OhmDazzle/YLD_Cup/Core/logic-framework.png

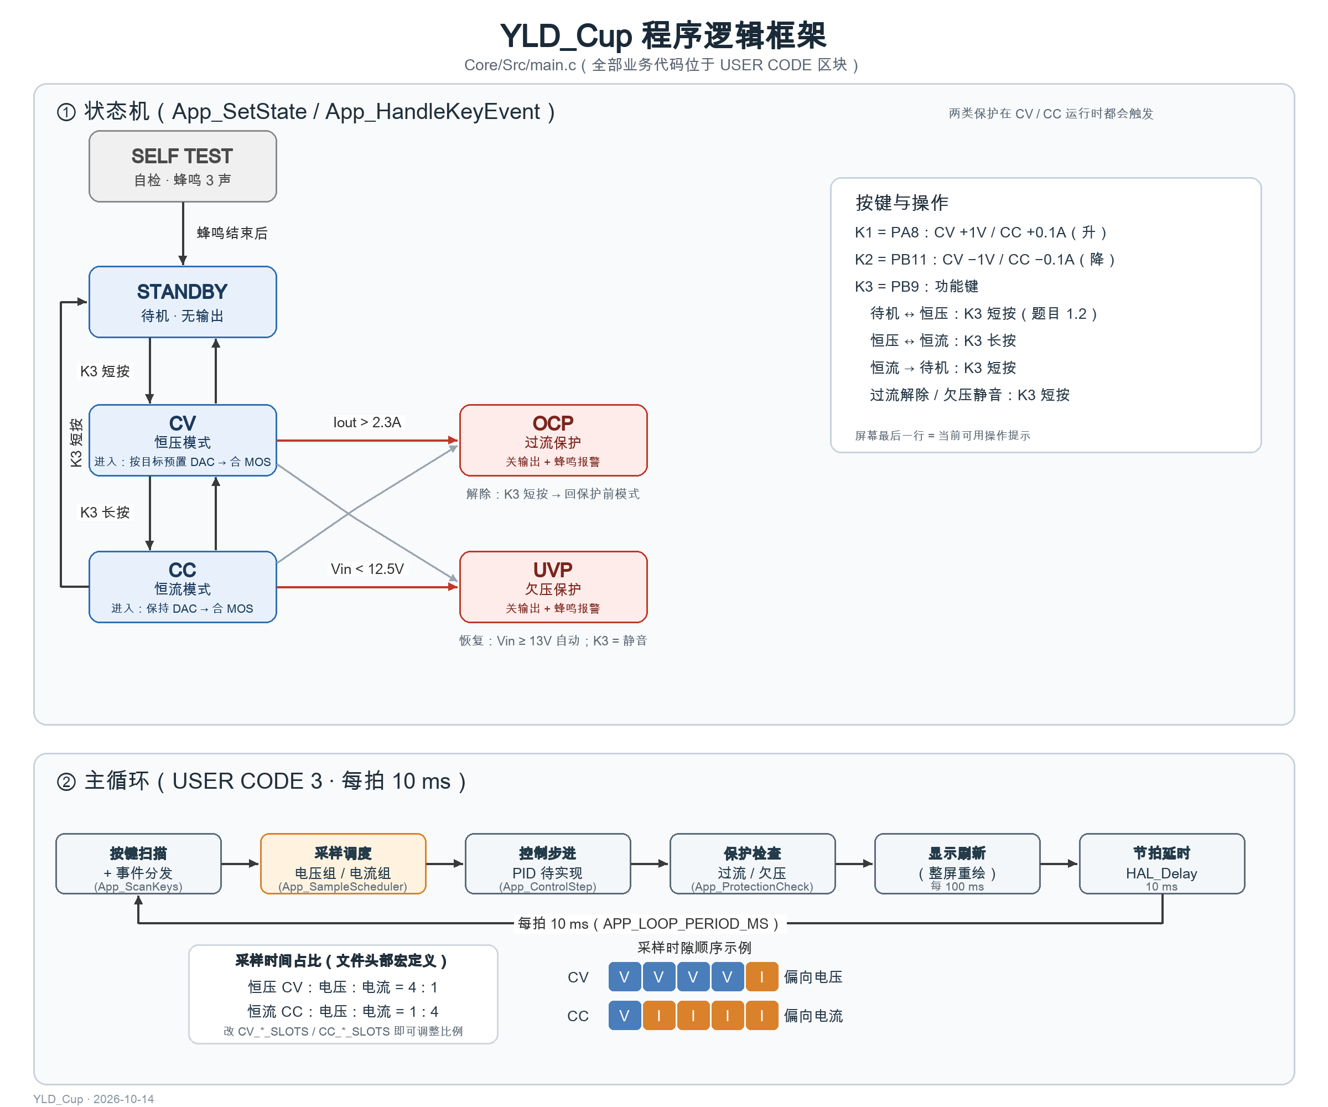
Core/logic-framework.png
