OhmDazzle/YLD_Cup/calibration/voltage_v2_2026-10-27.md

# V2.08 电压输出与采样校准

依据用户提供的《实验数据V2.pdf》，先用第二页校准 DAC 控制的端子输出，再用第一页校准 ADC 电压读数。用户确认采集固件为 V2.06/V2.07，并确认第一页第 20 组“测得输出电压”应为 **7.51V**。原始 `0.751` 保存在 `measurements_2026-10-27.json`，修订单独记录，计算时应用。两路电流、Vin 及保护阈值沿用原参数。

## 第二页：两步拟合 DAC 输出控制

第二页共 20 组，输入 16V，原设定电压 5、6、7、8、9V，负载电流 0.5、1、1.5、2A。表中没有 PA4 引脚的仪表读数，因此这是“DAC 命令到实际输出端子电压”的校准，不能据此声称独立校准了 PA4 的物理电压。

第一步：各电流组分别拟合 `V实际 = K × S + B`，其中 `S` 为原固件的设定电压。

| 电流 I / A | K | B / V |
| --- | --- | --- |
| 0.5 | 1.009 | -0.354 |
| 1.0 | 1.010 | -0.430 |
| 1.5 | 1.007 | -0.474 |
| 2.0 | 1.005 | -0.513 |

第二步：分别对 K、B 与电流 I 作线性最小二乘拟合：

```text
K(I) = 1.0115 - 0.003 × I
B(I) = -0.3125 - 0.1042 × I
V实际 = K(I) × S + B(I)
```

对于目标端子电压 `V目标`，反解原设定量，再沿用采集时的 DAC 基础映射：

```text
S补偿 = (V目标 + 0.3125 + 0.1042 × I) / (1.0115 - 0.003 × I)
Vdac = (17.07091 - S补偿) / 4.545455
DAC码 = round(Vdac × 4095 / 3.3)
```

例如目标 8V、负载 2A，`S补偿 ≈ 8.47429V`，`Vdac ≈ 1.89126V`，12 位 DAC 码约 **2347**。DAC 电压降低会提高电源输出，补偿方向与本板负增益通路一致。

主程序 `App_TargetToDac()`、开机预置、进入 CV、按键调压统一使用该反解。`App_ControlStep()` 在 CV 下每拍用最新校正电流更新静态前馈；CV 默认每五拍更新一次电流，屏幕平均不参与补偿。保护检查先于前馈执行；待机、保护、主程序 CC 不执行 CV 前馈。主程序的电压 PID 和恒流 PID 仍未实现。

范围处理：目标在 5-9V 时使用上述反解；高于 9V 或低于 5V 时保留边界处的校准增量，再加回目标电压，避免继续外推电压增益。电流用于 DAC 补偿时限制在 0-2A，0-0.5A 是向零电流的外推；大于 2A 时保持 2A 的补偿。**测量电流本身没有限到 2A**，过流判断仍使用真实换算值。最终 PA4 命令仍限在 0.2-3.1V，非有限值取 3.1V。

第二页仅在 16V 输入下采集，9V 目标反解的原设定量也会略高于原扫描上限；新电压、负载和温度条件均需复测。补偿不会提高降压芯片本身的带载能力。

## 第一页：ADC 输出电压校准

第一页共 20 组，均为 8V 设定的负载扫描，外表端子电压范围为 7.521-7.810V。其“测得输出电压”和“测得输出电流”已经使用 V2.06/V2.07 校准，不能再当成未经校准的 ADC 名义值。

这些电压和电流随负载一起变化，不能从这段窄扫描稳定分离出新的全量程电压增益与电流压降。保留原电压增益，对“外表读数减旧 OLED 电压”的残差按旧 OLED 已校正电流拟合：

```text
V新 = V旧 + 0.021567519 - 0.003348423 × Iout
```

其中 `Iout` 单位为 A。结合原有换算，固件的等价式为：

```text
Vnominal = PA6 引脚电压 × 7
V新 = 1.015199746 × Vnominal - 0.058501414 × Iout + 0.005166809
```

真实 0V 仍返回 0；负数钳为 0。电压组和电流组更新时，均从缓存的 `measVoutNominal` 重算，不会反复叠加校准。主程序和独立恒流调参固件共用新的 `Cal_Vout()`；独立调参程序继续直接控制 DAC，不叠加主程序的 CV 前馈。原始 ADC/DAC 模块测试与 `TEST/` 采集工具继续提供原始命令、原始读数。

## 回代结果与边界

| 项目 | 样本数 | 校准前平均绝对偏差 | 校准后平均绝对残差 | 校准后最大绝对残差 |
| --- | --- | --- | --- | --- |
| 第二页输出模型 | 20 | 388.50mV | 4.06mV | 7.90mV |
| 第二页模型反解并考虑 DAC 量化 | 20 | 388.50mV | 4.39mV | 7.50mV |
| 第一页 ADC 读数 | 20 | 18.05mV | 1.97mV | 5.88mV |

第一行是原设定量到原实测输出的模型回代。第二行保留每个原实测锚点的残差，按该电流的拟合斜率估计补偿后的变化，再计入 12 位 DAC 量化；属于模型估计，没有将正反函数相消得到的零误差当作验证。以上均为同批样本上的数值结果，OLED 数据仅显示到 0.01V，不能将这些残差宣称为烧录后毫伏级精度。

第一页未在第二页 DAC 新补偿启用后重新采集；ADC trim 仍可作用于同一测量链路，但新输出点，尤其 9-15V、0-0.5A 和负载瞬态，需独立台架复测。第一页与第二页相近条件下也有数十毫伏差异，说明重复条件及温度等会影响实际结果。

## 重现与验证

```sh
python3 calibration/fit_voltage_v2.py
python3 calibration/fit_measurements.py
python3 tests/run_voltage_calibration.py
python3 tests/run_measurement_calibration.py
python3 tests/run_main_logic.py
python3 tests/run_module_logic.py
python3 tests/run_cc_pid.py
python3 tests/run_buzzer_logic.py
cmake --preset Release
cmake --build --preset Release
```

`fit_voltage_v2.py` 先处理第二页，再处理第一页，生成 `Core/Inc/voltage_calibration.h` 与 `voltage_fit_results_2026-10-27.json`。`fit_measurements.py` 重现 V2.06 的基础系数，生成的共享测量头文件引用新电压头文件并应用一次 ADC 残差修正。两脚本无第三方依赖；原 2026-10-25 数据及审计保留为历史依据。

验证将 20 组 ADC 数据与 20 组 DAC 实测锚点送入实际 C 函数，覆盖量化、全 ADC 量程单调性、目标单调性与边界连续性。另回归原 35 组电流、主程序状态/保护、模块测试、蜂鸣器和独立恒流算法。软件验证通过不能替代上板复测；本次未烧录设备。
