OhmDazzle/YLD_Cup/TEST/logic-framework.png

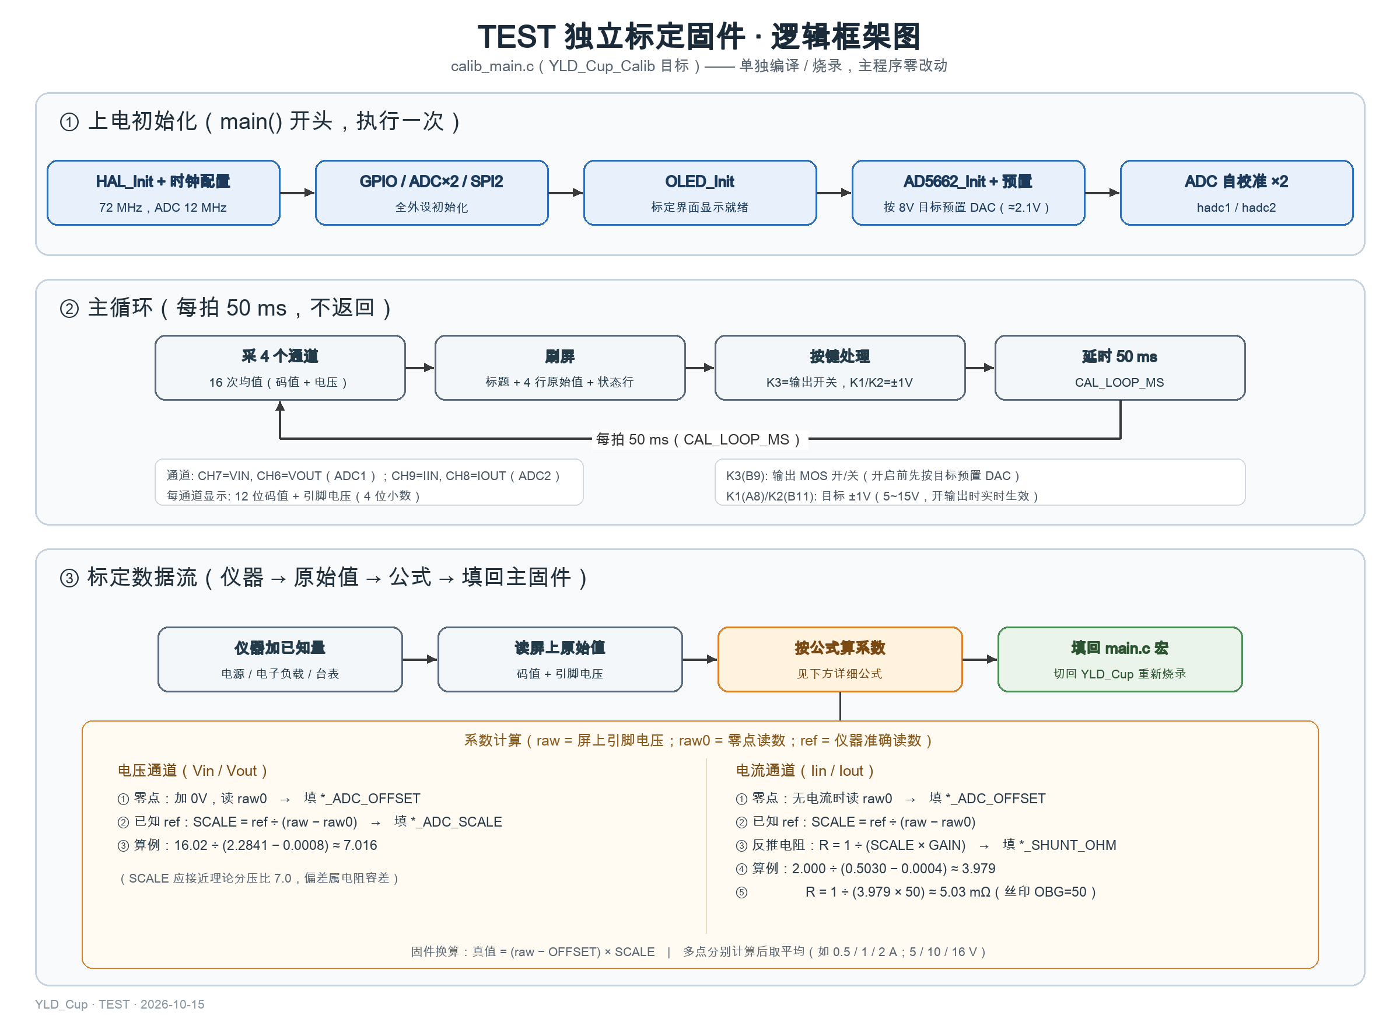
TEST/logic-framework.png
