OhmDazzle/YLD_Cup/YLD_CUP.ioc

Mcu.UserName=STM32G431CBTx
PA1.Signal=GPIO_Output
PA13.Signal=SYS_JTMS-SWDIO
PA14.Signal=SYS_JTCK-SWCLK
PA2.Signal=GPIO_Output
PA4.Signal=COMP_DAC11_group
PA6.Signal=ADC2_IN3
PA7.Signal=ADC2_IN4
PB0.Signal=ADC1_IN15
PB1.Signal=ADC1_IN12
PB13.Signal=GPIO_Input
PB14.Signal=GPIO_Input
PB15.Signal=GPIO_Input
PB3.Signal=GPIO_Output
PB4.Signal=GPIO_Output
PF0-OSC_IN.Signal=RCC_OSC_IN
PF1-OSC_OUT.Signal=RCC_OSC_OUT
