OhmDazzle/YLD_Cup/(commit log)

2026-09-24 V0.1 创建了一个文件夹
2026-09-24 V0.2 加入OLED模块 将江协科技OLED驱动加入代码库 SCL接PB8，SDA接PB9的测试未更改
2026-09-24 V0.3 借助cubemx打开端口复用功能
2026-09-24 V0.4 借助cubemx初始化四个ADC口
2026-09-24 V0.5 ADC端口读取电压，赋值给INA_*
2026-09-30 V0.6 修改时钟源为外部晶振
2026-09-30 V0.7 利用CubeMX初始化按键输入口，初始化三极管控制电路
2026-09-30 V0.7 利用CubeMX初始化DAC外设三个口
2026-09-30 V0.8 利用吃白饭的鲸鱼写了DAC外设的驱动，使用方式写入README文件
2026-09-30 V0.9 打开了SPI端口
2026-09-30 V1.0 初始设置电压1.23V
2026-09-30 V1.01 优化了一下代码
2026-10-01 V1.02 更改main标签
2026-10-11 V1.03 更改OLED驱动中引脚的连接，将文件使用说明写入README文档，将整个工程使用的引脚进行初始化
2026-10-11 V1.04 主循环接入OLED实时显示电压电流，重写工程README，新增AGENTS提交约定并更新AD5662文档现状
2026-10-11 V1.05 主逻辑框架：状态机/按键/采样占比调度/保护骨架，可调常量集中文件头部，同步README文档
2026-10-11 V1.06 文档：补充CubeMX重新生成安全清单；核对业务代码全部位于USER CODE区块
2026-10-13 V1.07 新增Core使用须知与程序逻辑框架图，根README补充入口链接
2026-10-14 V1.08 电流采样电阻改为自定义宏：IIN/IOUT_SHUNT_OHM + INA199_GAIN 自动折算 scale，同步文档
2026-10-15 V1.09 新增TEST采样标定模式：4通道原始值显示+输出控制，上电按住K3可临时进入，配套标定说明
2026-10-15 V1.10 TEST改为独立标定固件：YLD_Cup_Calib 单独编译/烧录，主程序恢复零改动
2026-10-15 V1.11 TEST 增加标定固件逻辑框架图（TEST/logic-framework.png），README 嵌入
2026-10-15 V1.12 TEST 标定公式详解：框架图公式区扩展为两栏分步推导，README §3 重写为详细计算版
2026-10-15 V1.13 修复 DAC_VMAX 注释乱码，移除只写不读的 buzzerMuted
2026-10-15 V1.14 过流保护加入持续时间窗确认 (OCP_CONFIRM_MS=50ms)，防负载瞬变误触发，同步文档
2026-10-17 V1.15 新增独立OLED测试固件
2026-10-17 V1.16 OLED测试固件增加K3长按蜂鸣器控制
2026-10-18 V1.17 非运行状态 Vout 显示强制 0.00V，修正待机约 10V 误显示，同步文档
2026-10-18 V1.18 ADC 采样链硬化：239.5 周期采样 + 丢弃通道切换首样本，开机蜂鸣后重采，抑制 0V 初始偏移与串扰，同步文档
2026-10-18 V1.19 显示数值加入约 300ms 滑动平均 (DISPLAY_AVG_TICKS)，保护仍用实时值，同步文档
2026-10-18 V1.20 移除零点/初始引脚电压基准 (offset)，测量仅保留比例标定，同步 README 与 TEST 说明
2026-10-18 V1.21 恒压模式调步进时同步写入 DAC（修复 K1/K2 只改显示、实际输出不变）
2026-10-18 V1.22 新增独立AD5662测试固件
2026-10-18 V1.23 修正AD5662 SPI2时钟相位并同步CubeMX配置
2026-10-20 V2.00 迁移至 STM32G431 并改用内部 DAC
2026-10-20 V2.01 适配新版采样电路与按键并补充标定及故障保护
2026-10-20 V2.02 新增独立运放采样及按键蜂鸣器模块测试
2026-10-20 V2.03 补充主程序与各测试固件流程说明
2026-10-25 V2.04 欠压保护增加3秒连续确认
2026-10-25 V2.05 新增独立恒流PID调参与阶跃验证固件
2026-10-25 V2.06 按实测数据校正采样换算并发布正式版
2026-10-27 V2.07 适配无源蜂鸣器PWM驱动
2026-10-27 V2.08 按实测数据两步校准DAC输出及ADC电压
2026-10-27 V2.10 加入恒压慢速积分反馈自动修正DAC
2026-10-27 V2.11 缩小恒压反馈死区至3mV
2026-10-27 V2.12 加快恒流调参采样并显示周期诊断
2026-10-27 V2.13 接入恒流快调与稳态微调控制
2026-10-27 V2.14 欠压关断并支持按键忽略本次告警
